Arun-Sur/Wireless-EEG-Machine/(list of files, drawings)

Other design files:
circuits/Basic Protection circuit.ms14
circuits/Complete EEG circuit.ms14
circuits/High pass filter.ms14
circuits/Instrumentation amplifier.ms14
circuits/Low pass filter.ms14
