Arun-Sur/Wireless-EEG-Machine/(commit log)

2026-03-10 Initial Project upload
    [Basic Protection circuit.ms14, Complete EEG circuit.ms14, High pass filter.ms14, Instrumentation amplifier.ms14, Low pass filter.ms14]
2026-03-10 Rename High pass filter .png to High_pass_filter.png
2026-03-10 Rename Low pass filter.png to Low_pass_filter.png
2026-03-10 Rename Notch filter.png to Notch_filter.png
2026-03-10 Rename Wireless_EEG_Machine Project.pdf to Wireless_EEG_Machine_Project.pdf
